mike-rankin/SAMD21G18A_Sensor_Board/PCB/BOM_Sensor_Board_Rev2.xlsx

Sheet: Part List Report
 | Component list |  |  | Sensor Board
 | Source Data From: |  |  | Rev2
 | Project:
 | Report Date: |  | 9/15/2016 | 10:29:16 AM
 | Print Date: |  | 2016-09-15 | 10:37:11
# | Designator | Quantity | Vendor | PartNumber | Description | Manufacturer | Comment
1 | C1, C2, C3, C15 | 4 | Digi-Key | GRM188R71E105KA12D | CAP, 1uF, 25V, 0603 | Murata | 1uF
2 | C4 | 1 | Digi-Key | GRM188R71H103KA01D | CAP, 0.01uF, 0603 | Murata | 0.01uF
3 | C5, C6, C8, C11, C14, C20 | 6 | Digi-Key | GRM188R71E104KA01D | CAP, 0.1uF, 25V, 0603 | Murata | 0.1uF
4 | C7 | 1 | Digi-Key | GRM188R61E475KE11D | CAP, 4.7uF, 25V, 0603 | Murata | 4.7uF
5 | C9 | 1 | Digi-Key | GRM31CR71E106KA12L | CAP, 10uF, 25V, 1206 | Murata | 10uF
6 | C10 | 1 | Digi-Key | GRM188R61C225KE15D | CAP, 2.2uF, 25V, 0603 | Murata | 2.2uF
7 | C12, C13 | 2 | Digi-Key | GRM1885C1H220JA01D | CAP, 22pF, 0603 | Murata | 22pF
8 | C16, C17, C18, C19 | 4 | Digi-Key | GRM31CR71E475KA88L | CAP, 4.7uF, 25V, 1206 | Murata | 4.7uF
9 | D1 | 1 | Digi-Key | HSMF-C115 | LED,RGB,10mA,SMD,R/A,RoHS | AVAGO | RGB
10 | H1 | 1 | Digi-Key | 1981584-1 | CONN RCPT MICRO USB TYPE AB | TE Connectivity | Micro USB
11 | H2 | 1 |  |  | EMPTY SOLDER 2POS |  | CON2
12 | H3 | 1 |  | PADS | JTAG CONN HEADER 5X2POS 50mil" PADS |  | CON5X2-50MIL
13 | J1 | 1 | Digi-Key | 0473092851 | 9 (8 + 1) microSD SMT, Right Angle | Molex | 0473092851
14 | R1, R2, R3, R4, R5, R7, R8, R10, R15, R16 | 10 | Digi-Key | ERJ-3EKF1002V | RES, 10K, 0603 | Panasonic | 10K
15 | R6 | 1 | Digi-Key | ERJ-3EKF3903V | RES, 390K, 0603 | Panasonic | 390K
16 | R9, R11, R13 | 3 | Digi-Key | ERJ-3EKF4700V | RES, 470R, 0603 | Panasonic | 470R
17 | R12 | 1 | Digi-Key | ERJ-3EKF1001V | RES, 470R, 0603 | Panasonic | 1K
18 | R14 | 1 | Digi-Key | ERJ-3GEY0R00V | RES, 0R, 0603 | Panasonic | 0R
19 | R17 | 1 | Digi-Key | ERJ-3EKF3300V | RES, 330R, 0603 | Panasonic | 330R
20 | S1 | 1 | DX.com | 122745 | DX_Navigation Switch |  | Navigation Switch
21 | S2 | 1 | DX.com | 122531 | DX_SWITCH SLIDE SPDT R/A
22 | S3 | 1 | Digi-Key | FSM6JSMA | SWITCH TACTILE SPST-NO 0.05A 12V | TE Connectivity | Tactile_Switch
23 | S4 | 1 | DX.com | 122514 | DX_SWITCH TACTILE |  | Push
24 | U1 | 1 | Digi-Key | HDC1080DMBT | Humidity/Temperature Sensor | Texas Instruments | HDC1080DMBT
25 | U2 | 1 | Digi-Key | ADXL345BCCZ-RL7 | IC ACCEL SPI/I2C 3AX 14LGA | Analog Devices | ADXL345BCCZ-RL7
26 | U3 | 1 | Digi-Key | DS1340U-33+ | IC RTC SERIAL 512K 8-TSSOP | Maxim | DS1340U-33+
27 | U4 | 1 | Digi-Key | ATSAMD21G18A-MU | IC MCU 32BIT 256KB FLASH 48QFN | Atmel | ATSAMD21G18A-MU
28 | U5 | 1 | Digi-Key | MCP73833-FCI/UN | IC LI-ION/LI-POLY CTRLR 10MSOP | Microchip | MCP73833-FCI/UN
29 | U6 | 1 | Digikey | LP2985-33DBVR | IC REG LDO 3.3V .15A SOT23-5 | Texas Instruments | LP2985-33DBVR
30 | X1 | 1 | Buy-Display | ER-OLED0.66-1B | 0.66 inch OLED_GLASS_Blue | Buy-Display | OLED_GLASS 0.66 inch
31 | X2, X3 | 2 | Digi-Key | ECS-.327-12.5-34B | CRYSTAL 32.768 KHZ 12.5PF SMD | ECS | ECS-.327-12.5-34B
Approved |  |  |  | Notes

Sheet: Project Information
Project Full Path | C:\Utility\Dropbox\Arduino_PCB\SAMD21G18A\Sensor_Board\Sensor_Board_Rev2.PrjPcb
Project Filename | Sensor_Board_Rev2.PrjPcb
Variant Name | None
Data-Source Filename | Sensor_Board_Rev2.PrjPcb
Data-Source Full Path | C:\Utility\Dropbox\Arduino_PCB\SAMD21G18A\Sensor_Board\Sensor_Board_Rev2.PrjPcb
Title | <Parameter Title not found>
Total Quantity | 55
Report Time | 10:29:16 AM
Report Date | 9/15/2016
Report Date & Tine | 9/15/2016 10:29:16 AM
Output Name | Bill of Materials
Output Type | BOM_PartType
Output Generator Name | BOM
Output Generator Description | Bill of Materials
