mike-rankin/SAMD21G18A_Sensor_Board/PCB/SAMD21G18A_Sensor_Board_Rev1.PDF

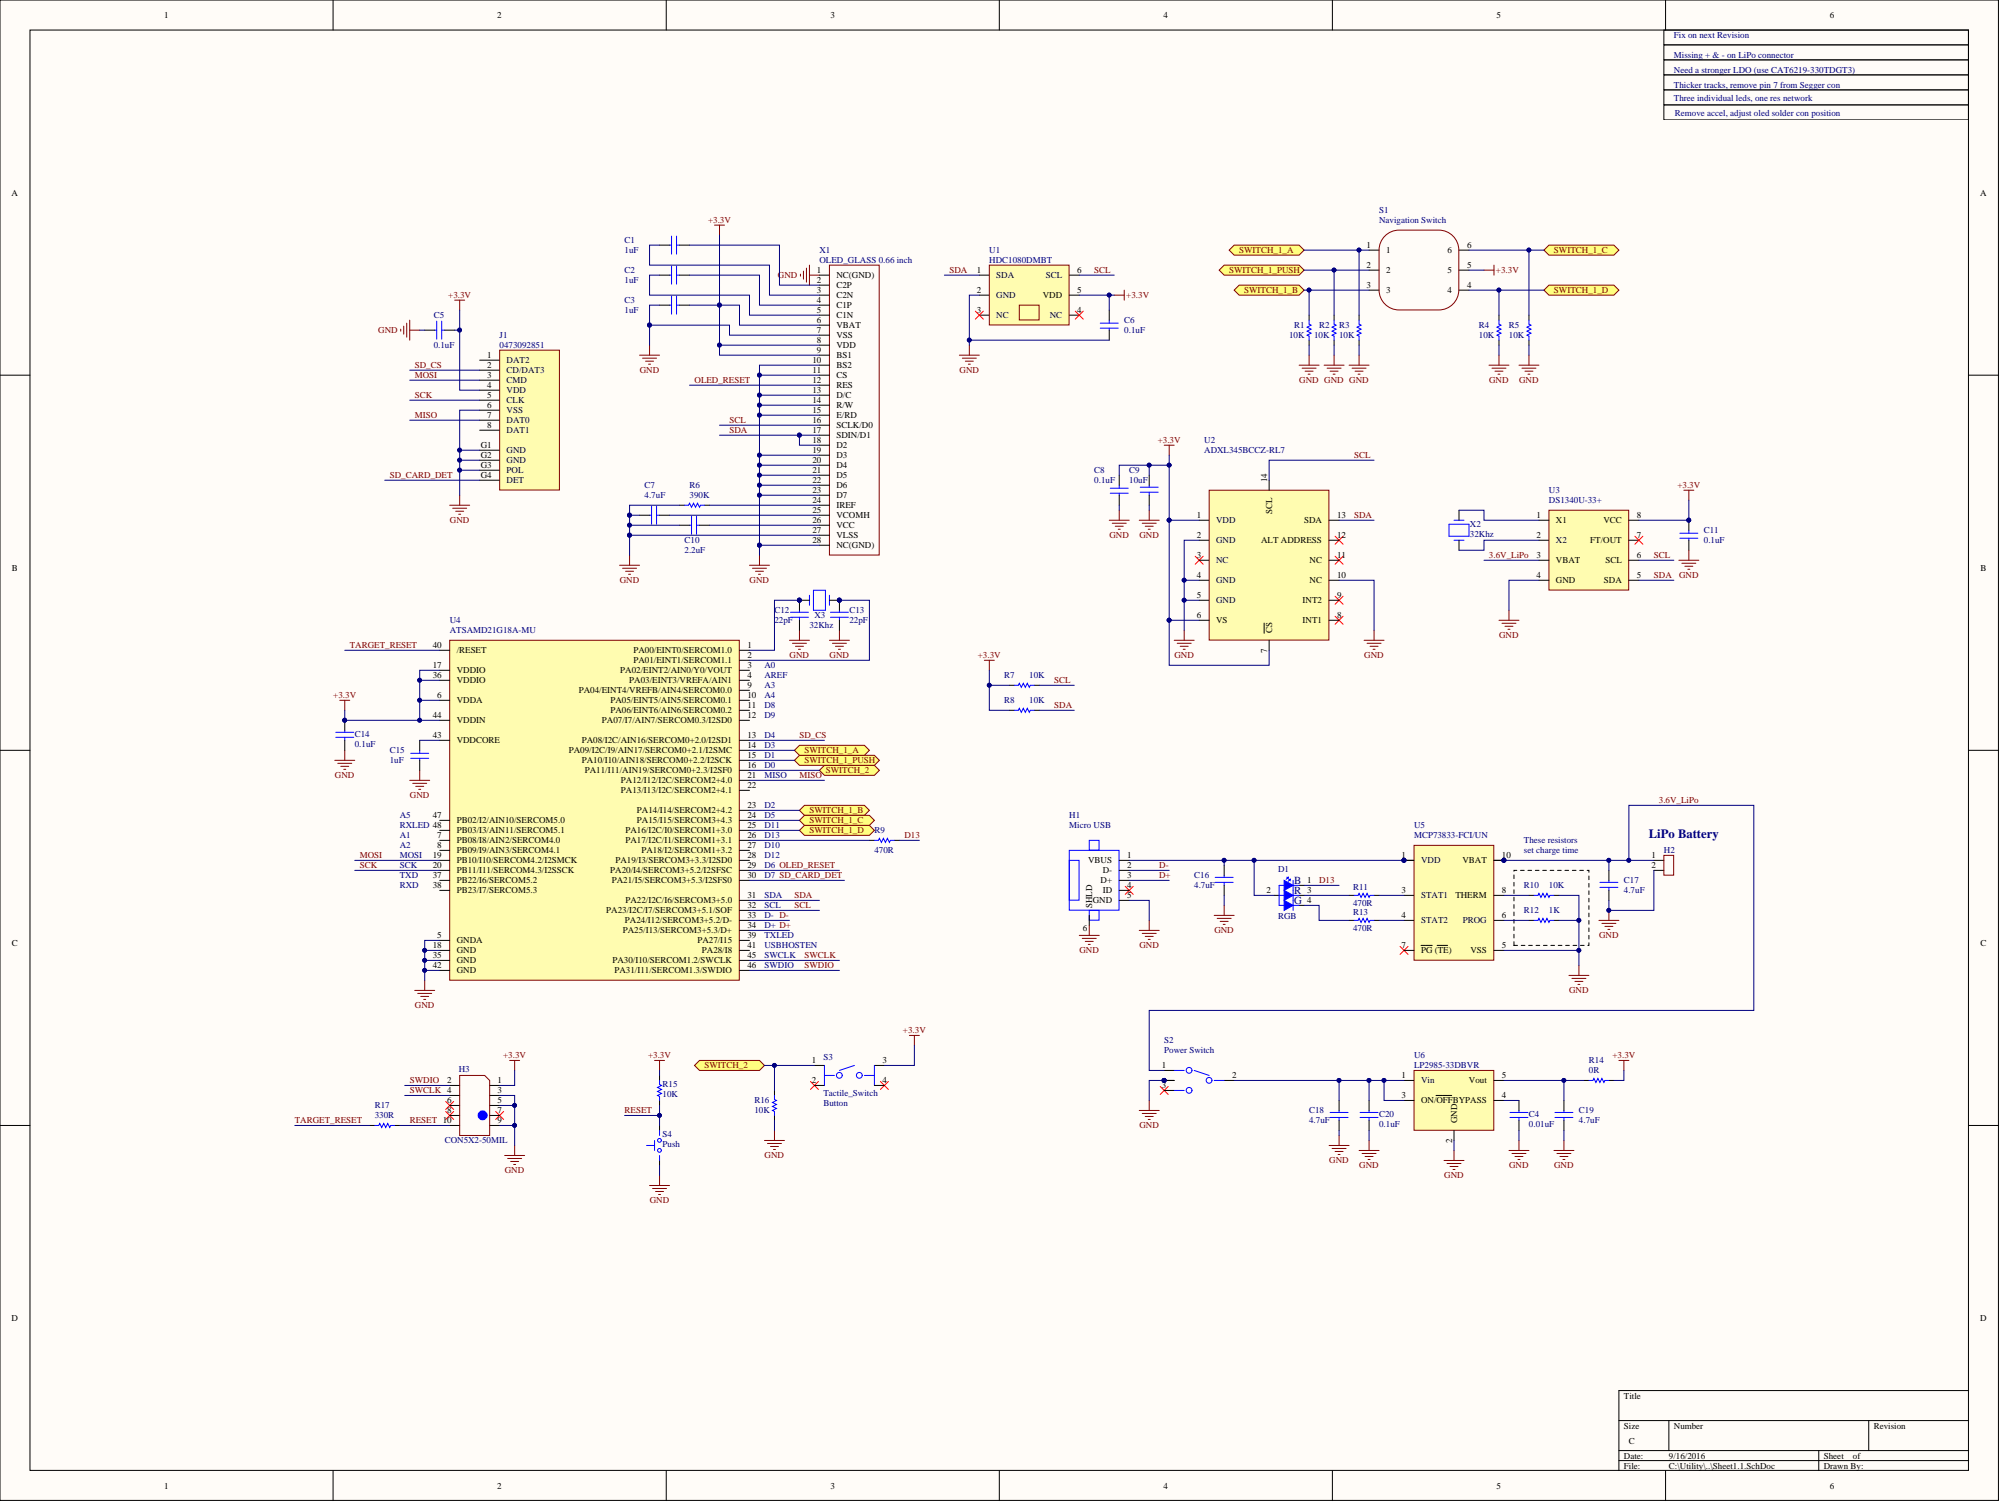
[picture p1: page 1]

Fix on next Revision

Missing + & - on LiPo connector
Need a stronger LDO (use CAT6219-330TDGT3)
Thicker tracks, remove pin 7 from Segger con
Three individual leds, one res network
Remove accel, adjust oled solder con position

VSS 7

CMD 3
VDD 4

VCC 26

NC(GND) 28

VDDIO 36

VDDA 6

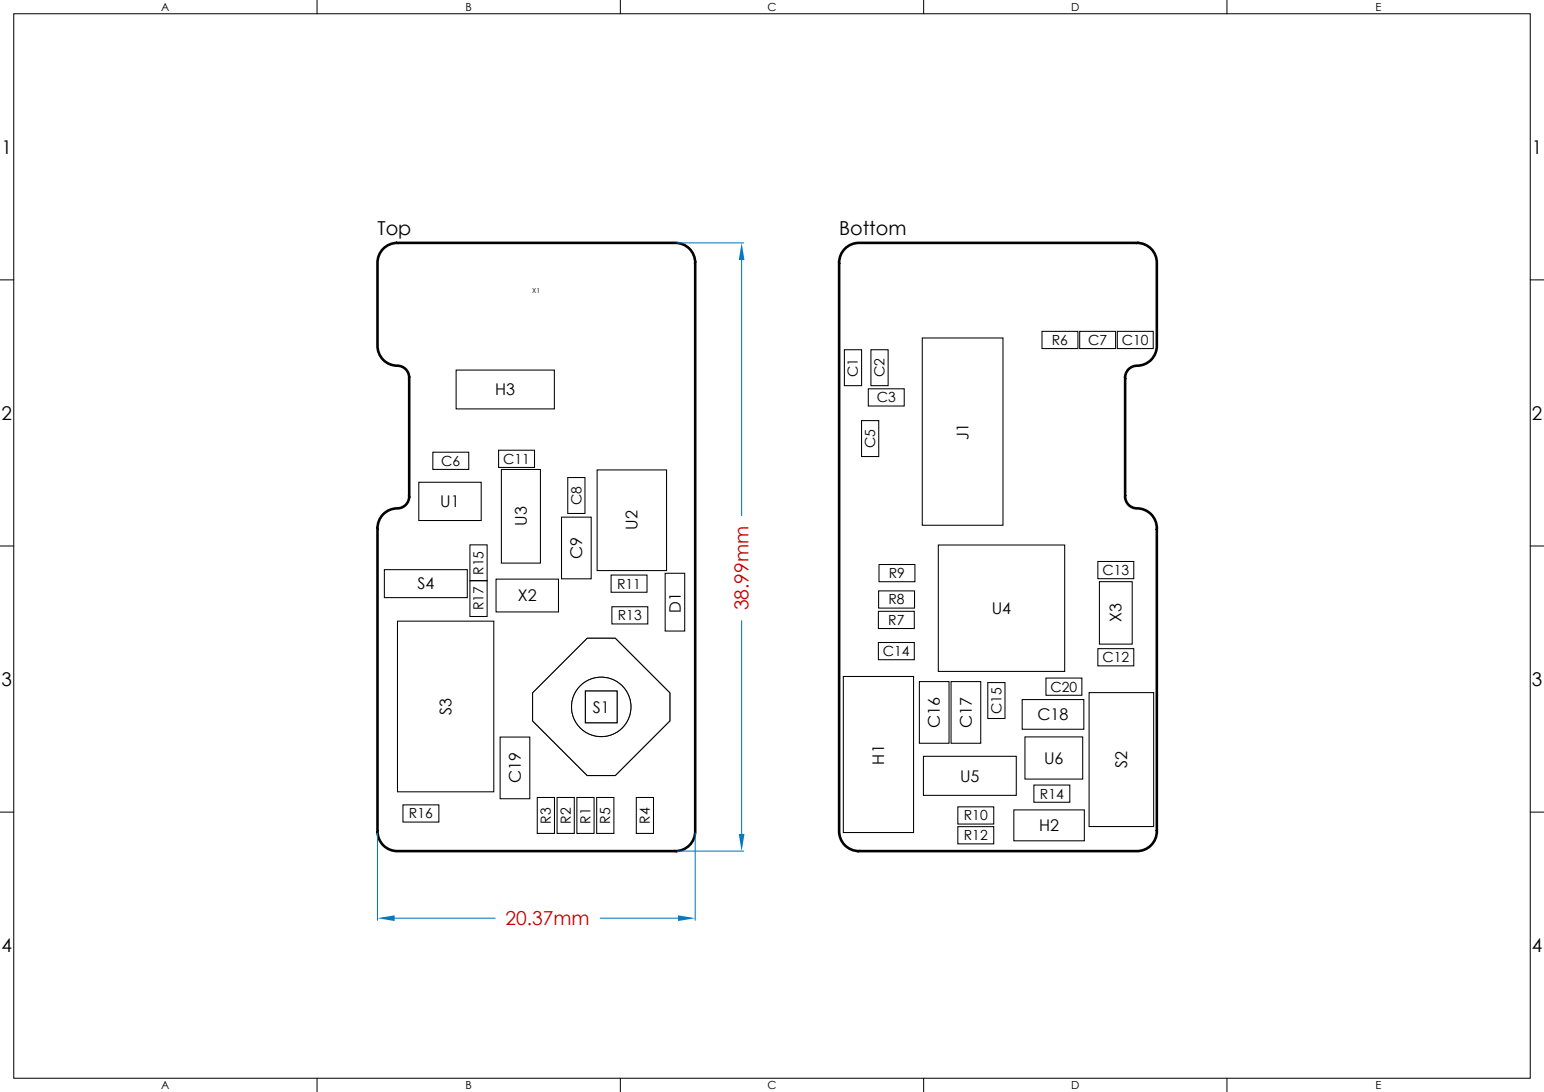
[picture p2: page 2]
